GChalony/MeloBox/docs/front_v2.jpg

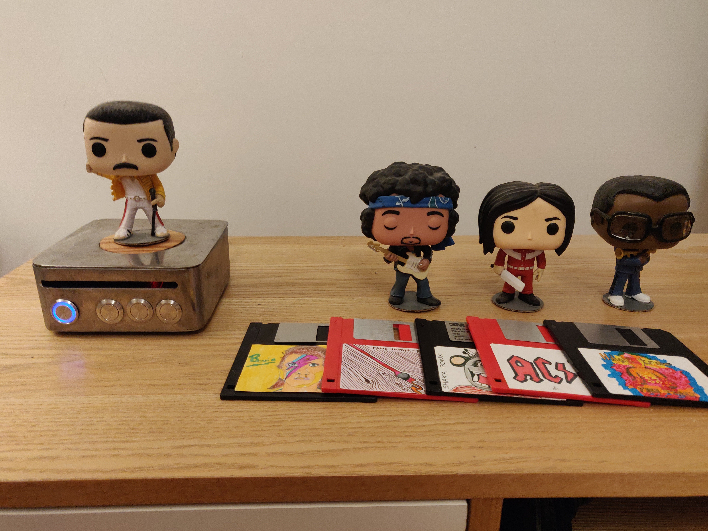
docs/front_v2.jpg
