GChalony/MeloBox/src/examples/spotify_web_api.py

import requests

CLIENT_ID = "72100a4c5fb54d419ab71c5469cedbad"
CLIENT_SECRET = "4f6f337860c241bf9c502280927fa226"

AUTH_URL = 'https://accounts.spotify.com/api/token'


"""Client credentials is limited to public endpoint and can't access user data. """
def client_credentials_demo():
    auth_response = requests.post(AUTH_URL, {
        'grant_type': 'client_credentials',
        'client_id': CLIENT_ID,
        'client_secret': CLIENT_SECRET,
    })

    # convert the response to JSON
    auth_response_data = auth_response.json()

    # save the access token
    access_token = auth_response_data['access_token']

    print(auth_response_data)

    headers = {
        'Authorization': 'Bearer {token}'.format(token=access_token)
    }

    BASE_URL = 'https://api.spotify.com/v1/'

    # Track ID from the URI
    track_id = '6y0igZArWVi6Iz0rj35c1Y'

    # actual GET request with proper header
    r = requests.get(BASE_URL + 'audio-features/' + track_id, headers=headers)

    print(r.json())


def authorization_demo():

    # List available devices
    print(requests.get("https://api.spotify.com/v1/me/player/devices", headers=headers).json())
