GChalony/MeloBox/src/examples/turn_led_on.py

from time import sleep
from RPi import GPIO

POWER_LED = 19

GPIO.setmode(GPIO.BOARD)

GPIO.setup(POWER_LED, GPIO.OUT)
GPIO.output(POWER_LED, GPIO.HIGH)

try:
    while True:
        sleep(1)
finally:
    GPIO.cleanup()
