GChalony/MeloBox/(commit log)

2022-03-05 Add shop list
    [shop_list.csv]
2022-03-05 Implement Led and Button interfaces
2022-03-13 Print when tag detected to understand delay
2022-03-14 Exchange buttons
2022-04-27 Add test scripts for power button
2022-04-27 Add some Arduino examples
2022-04-27 Notes abouts freecad and wiring
2022-05-05 Add PCB
    [shop_list.csv]
2022-06-06 Allow for shortened URIs
    [nfc.py]
2022-06-06 Retry to connect five times to Spotify device
2022-06-06 Test interrupt pin
2022-06-06 Set green LED when button pressed
    Doesn't work very well though
    [gpio.py, hardware.py]
